koorinivash/physioband-ai1/ml/reports/synthetic_random_forest_confusion_matrix.png

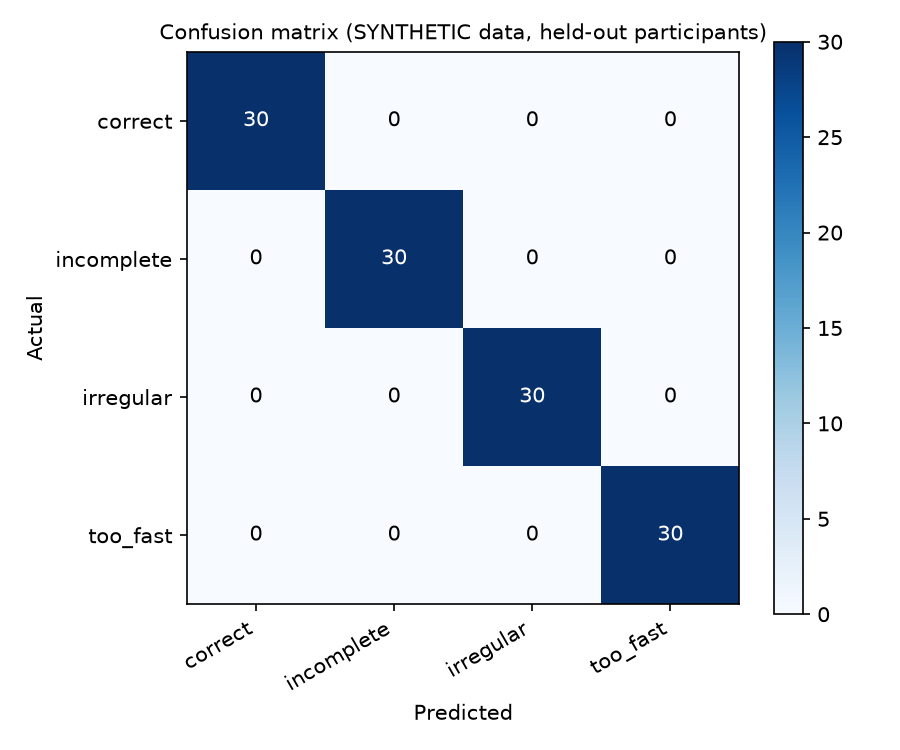
ml/reports/synthetic_random_forest_confusion_matrix.png
