koorinivash/physioband-ai1/ml/reports/synthetic_random_forest_feature_importance.png

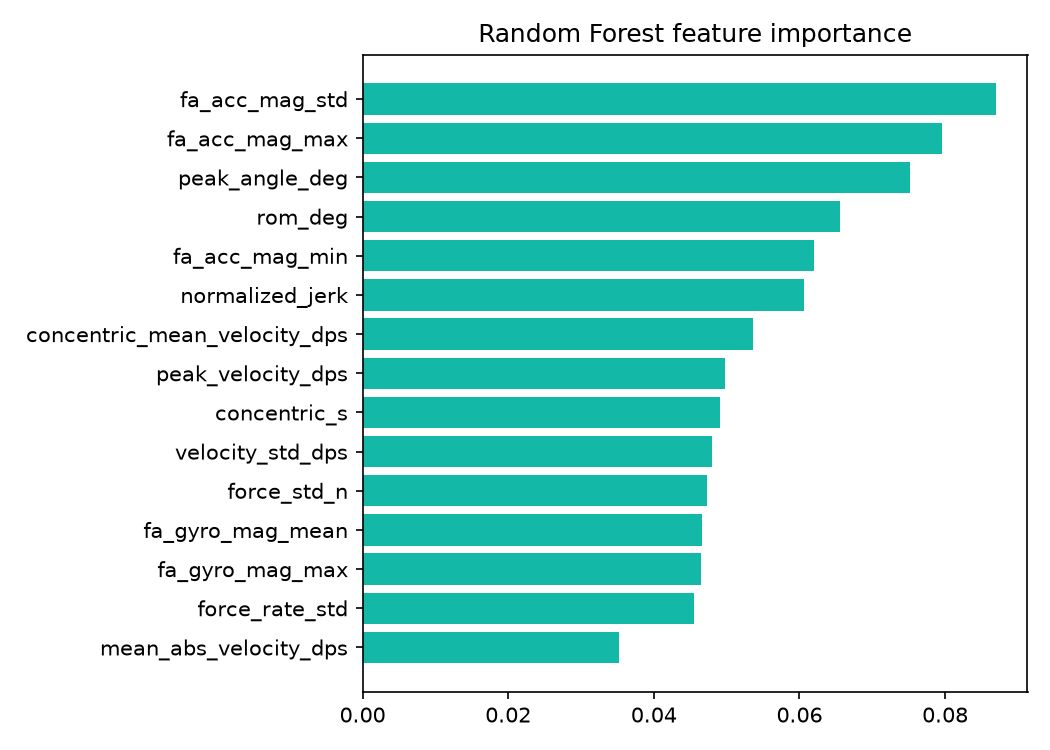
ml/reports/synthetic_random_forest_feature_importance.png
