koorinivash/physioband-ai1/ml/reports/synthetic_random_forest_test_predictions.csv

participant_id | session_id | rep_number | label | predicted
SYN-P02 | SYN-P02-correct-1 | 1 | correct | correct
SYN-P02 | SYN-P02-correct-1 | 2 | correct | correct
SYN-P02 | SYN-P02-correct-1 | 3 | correct | correct
SYN-P02 | SYN-P02-correct-1 | 4 | correct | correct
SYN-P02 | SYN-P02-correct-1 | 5 | correct | correct
SYN-P02 | SYN-P02-correct-1 | 6 | correct | correct
SYN-P02 | SYN-P02-correct-1 | 7 | correct | correct
SYN-P02 | SYN-P02-correct-1 | 8 | correct | correct
SYN-P02 | SYN-P02-correct-1 | 9 | correct | correct
SYN-P02 | SYN-P02-correct-1 | 10 | correct | correct
SYN-P02 | SYN-P02-incomplete-1 | 1 | incomplete | incomplete
SYN-P02 | SYN-P02-incomplete-1 | 2 | incomplete | incomplete
SYN-P02 | SYN-P02-incomplete-1 | 3 | incomplete | incomplete
SYN-P02 | SYN-P02-incomplete-1 | 4 | incomplete | incomplete
SYN-P02 | SYN-P02-incomplete-1 | 5 | incomplete | incomplete
SYN-P02 | SYN-P02-incomplete-1 | 6 | incomplete | incomplete
SYN-P02 | SYN-P02-incomplete-1 | 7 | incomplete | incomplete
SYN-P02 | SYN-P02-incomplete-1 | 8 | incomplete | incomplete
SYN-P02 | SYN-P02-incomplete-1 | 9 | incomplete | incomplete
SYN-P02 | SYN-P02-incomplete-1 | 10 | incomplete | incomplete
SYN-P02 | SYN-P02-too_fast-1 | 1 | too_fast | too_fast
SYN-P02 | SYN-P02-too_fast-1 | 2 | too_fast | too_fast
SYN-P02 | SYN-P02-too_fast-1 | 3 | too_fast | too_fast
SYN-P02 | SYN-P02-too_fast-1 | 4 | too_fast | too_fast
SYN-P02 | SYN-P02-too_fast-1 | 5 | too_fast | too_fast
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
SYN-P09 | SYN-P09-incomplete-1 | 10 | incomplete | incomplete
SYN-P09 | SYN-P09-too_fast-1 | 1 | too_fast | too_fast
SYN-P09 | SYN-P09-too_fast-1 | 2 | too_fast | too_fast
SYN-P09 | SYN-P09-too_fast-1 | 3 | too_fast | too_fast
SYN-P09 | SYN-P09-too_fast-1 | 4 | too_fast | too_fast
SYN-P09 | SYN-P09-too_fast-1 | 5 | too_fast | too_fast
SYN-P09 | SYN-P09-too_fast-1 | 6 | too_fast | too_fast
SYN-P09 | SYN-P09-too_fast-1 | 7 | too_fast | too_fast
SYN-P09 | SYN-P09-too_fast-1 | 8 | too_fast | too_fast
SYN-P09 | SYN-P09-too_fast-1 | 9 | too_fast | too_fast
SYN-P09 | SYN-P09-too_fast-1 | 10 | too_fast | too_fast
SYN-P09 | SYN-P09-irregular-1 | 1 | irregular | irregular
SYN-P09 | SYN-P09-irregular-1 | 2 | irregular | irregular
SYN-P09 | SYN-P09-irregular-1 | 3 | irregular | irregular
SYN-P09 | SYN-P09-irregular-1 | 4 | irregular | irregular
SYN-P09 | SYN-P09-irregular-1 | 5 | irregular | irregular
SYN-P09 | SYN-P09-irregular-1 | 6 | irregular | irregular
SYN-P09 | SYN-P09-irregular-1 | 7 | irregular | irregular
SYN-P09 | SYN-P09-irregular-1 | 8 | irregular | irregular
SYN-P09 | SYN-P09-irregular-1 | 9 | irregular | irregular
SYN-P09 | SYN-P09-irregular-1 | 10 | irregular | irregular
